11mbs/Laser-Drivers/03-LMH13000-Driver/Production-files/bom.csv

Designator | Footprint | Quantity | Value | LCSC Part #
C1, C12, C7 | 805 | 3 | 10uF
C10, C15, C3 | 402 | 3 | 10nF
C11, C5 | 402 | 2 | 100nF low-ESL
C13, C2, C8 | 603 | 3 | 1uF
C14, C19, C9 | 402 | 3 | 100nF
C16, C17 | 402 | 2 | 220pF
C18, C4 | 402 | 2 | 1nF
C20, C6 | 1206 | 2 | 47uF
FB1, FB2 | 805 | 2 | FerriteBead | C16903
J1 | PinHeader_1x03_P2.54mm_Vertical | 1 | Conn_01x03_Pin | C42431836
LD1 | JST_XH_B2B-XH-A_1x02_P2.50mm_Vertical | 1 | D_Laser_1C2A | C495685
Q1 | SOT-23 | 1 | 2N7002 | C124475
R1 | 805 | 1 | 560
R10, R9 | 402 | 2 | 5.1
R11, R3 | 603 | 2 | 20K
R2 | 402 | 1 | 100K
R4 | 402 | 1 | 100
R5 | 402 | 1 | 10K
R6 | 603 | 1 | 100K
R7 | 2512 | 1 | 0.1 | C49164916
R8 | 603 | 1 | 1K
RV1 | Potentiometer_Bourns_3296W_Vertical | 1 | 25K | C55264
U1 | XLMH13000RQER.A_WQFN-HR_TXI_TEX | 1 | LMH13000RQER | C48892016
U2 | DBV0005A_N | 1 | SN65LVDS1DBVR | C465731
