11mbs/Laser-Drivers/03-LMH13000-Driver/KiCad/LMH13000_Laser_Driver_v1-2/LMH13000_Laser_Driver.kicad_pcb

## KiCad design 03-LMH13000-Driver/KiCad/LMH13000_Laser_Driver_v1-2/LMH13000_Laser_Driver.kicad_pcb (2026-11-04)

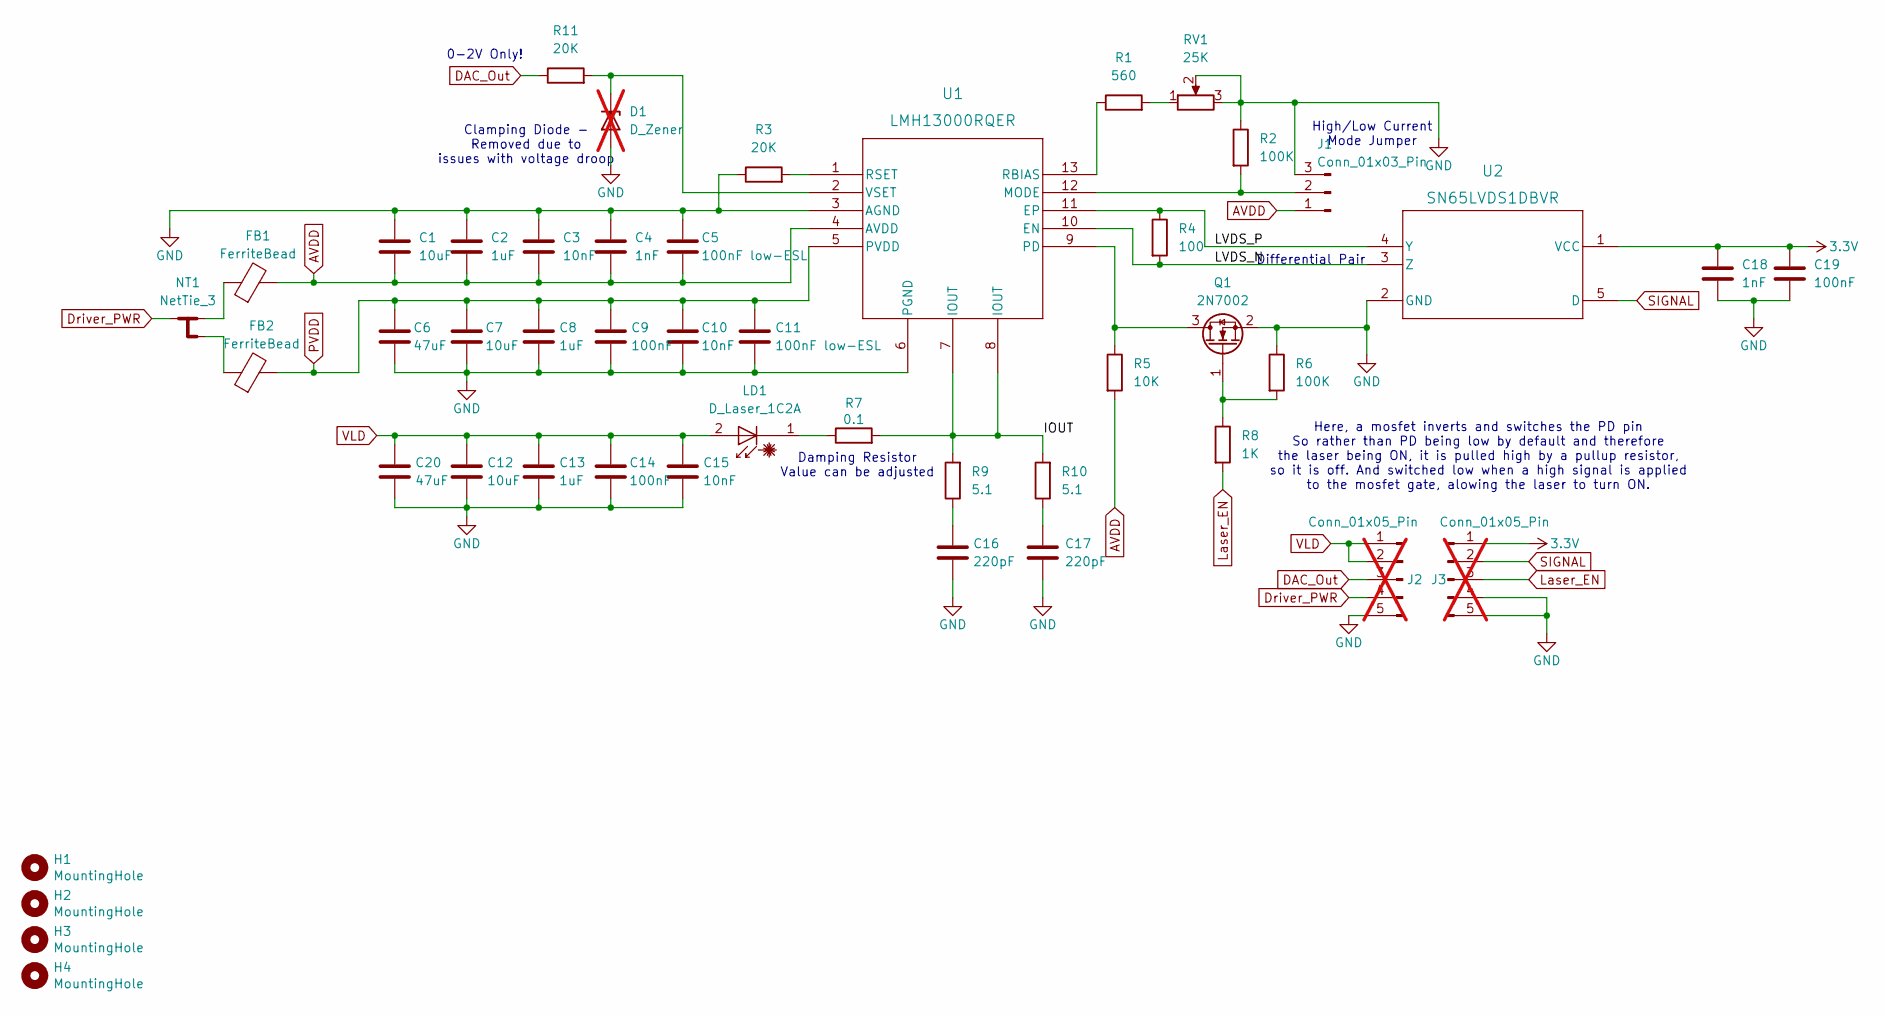
[picture p1: schematic LMH13000_Laser_Driver.kicad_sch, LM13000 Analog Laser Driver]

Parts:
C1, C7, C12: 10uF; C_0805_2012Metric
C2, C8, C13: 1uF; C_0603_1608Metric
C3, C10, C15: 10nF; C_0402_1005Metric
C4, C18: 1nF; C_0402_1005Metric
C5, C11: 100nF low-ESL; C_0402_1005Metric
C6, C20: 47uF; C_1206_3216Metric
C9, C14, C19: 100nF; C_0402_1005Metric
C16, C17: 220pF; C_0402_1005Metric
D1: D_Zener; D_SOD-523; LCSC Part C2760566; not fitted
FB1, FB2: FerriteBead; L_0805_2012Metric; LCSC Part C16903
H1, H2, H3, H4: MountingHole; MountingHole_3.2mm_M3
J1: Conn_01x03_Pin; PinHeader_1x03_P2.54mm_Vertical; LCSC Part C42431836
J2, J3: Conn_01x05_Pin; PinHeader_1x05_P2.54mm_Vertical; LCSC Part C42431835; not fitted
LD1: D_Laser_1C2A; JST_XH_B2B-XH-A_1x02_P2.50mm_Vertical; LCSC Part C495685
NT1: NetTie_3; NetTie-3_SMD_Pad0.5mm
Q1: 2N7002; SOT-23; LCSC Part C124475
R1: 560; R_0805_2012Metric
R2: 100K; R_0402_1005Metric
R3, R11: 20K; R_0603_1608Metric
R4: 100; R_0402_1005Metric
R5: 10K; R_0402_1005Metric
R6: 100K; R_0603_1608Metric
R7: 0.1; R_2512_6332Metric_Pad1.40x3.35mm_HandSolder; LCSC Part C49164916
R8: 1K; R_0603_1608Metric
R9, R10: 5.1; R_0402_1005Metric
RV1: 25K; Potentiometer_Bourns_3296W_Vertical; LCSC Part C55264
U1: LMH13000RQER; XLMH13000RQER.A_WQFN-HR_TXI_TEX; LCSC Part C48892016
U2: SN65LVDS1DBVR; DBV0005A_N; LCSC Part C465731

Connections:
3.3V: C18.1, C19.1, J3.1, U2.1 (VCC)
/IOUT: R7.2, R9.2, R10.2, U1.7 (IOUT), U1.8 (IOUT)
/LVDS_N: R4.2, U1.10 (EN), U2.3 (Z)
/LVDS_P: R4.1, U1.11 (EP), U2.4 (Y)
AVDD: C1.2, C2.2, C3.2, C4.2, C5.2, FB1.2, J1.1, R5.2, U1.4 (AVDD)
DAC_Out: J2.3, R11.1
Driver_PWR: J2.4, NT1.2
GND: C1.1, C2.1, C3.1, C4.1, C5.1, C6.2, C7.2, C8.2, C9.2, C10.2, C11.2, C12.2, C13.2, C14.2, C15.2, C16.2, C17.2, C18.2, C19.2, C20.2, D1.2 (A), J1.3, J2.5, J3.4, J3.5, Q1.2 (S), R2.1, R3.1, R6.1, RV1.2, RV1.3, U1.3 (AGND), U1.6 (PGND), U2.2 (GND)
Laser_EN: J3.3, R8.2
unnamed: C16.1, R9.1
unnamed: C17.1, R10.1
unnamed: D1.1 (K), R11.2, U1.2 (VSET)
unnamed: FB1.1, NT1.1
unnamed: FB2.1, NT1.3
unnamed: J1.2, R2.2, U1.12 (MODE)
unnamed: LD1.1 (K), R7.1
unnamed: Q1.3 (D), R5.1, U1.9 (PD)
unnamed: Q1.1 (G), R6.2, R8.1
unnamed: R1.2, RV1.1
unnamed: R1.1, U1.13 (RBIAS)
unnamed: R3.2, U1.1 (RSET)
PVDD: C6.1, C7.1, C8.1, C9.1, C10.1, C11.1, FB2.2, U1.5 (PVDD)
SIGNAL: J3.2, U2.5 (D)
VLD: C12.1, C13.1, C14.1, C15.1, C20.1, J2.1, J2.2, LD1.2 (A)

Notes on the sheet:
High/Low Current Mode Jumper
Clamping Diode - Removed due to issues with voltage droop
Differential Pair
Damping Resistor Value can be adjusted
Here, a mosfet inverts and switches the PD pin So rather than PD being low by default and therefore the laser being ON, it is pulled high by a pullup resistor, so it is off. And switched low when a high signal is applied to the mosfet gate, alowing the laser to turn ON.
0-2V Only!

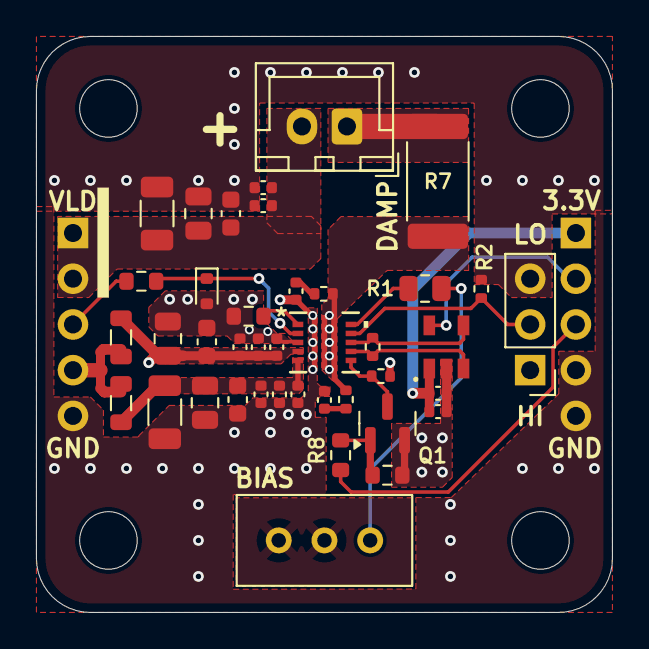
[picture p2: board LMH13000_Laser_Driver.kicad_pcb from above]

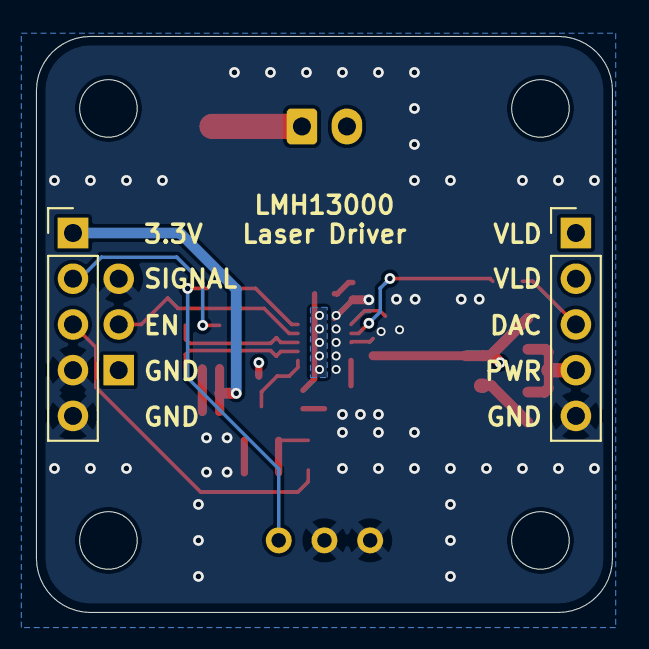
[picture p3: board LMH13000_Laser_Driver.kicad_pcb from below]

Board: 4 copper layers, 32.0 x 32.0 mm, 47 parts (2 on the bottom side), 24 nets.
